Stromi1011/SelfBalancingRobot_Woita/README.md

# SelfBalancingRobot_Woita
Repository für unser Self-balancing-robot Projekt in PMT2

Die Sourcecodes, Artikel und Blender-Files sind in den jeweiligen Verzeichnissen zu finden.

Die für dieses Projet vervendete MPU6050 Bibliothek ist hier zu finden:
https://github.com/jarzebski/Arduino-MPU6050
