Stromi1011/SelfBalancingRobot_Woita/3D-Models/Gerust_self_balancing_Robot.stl

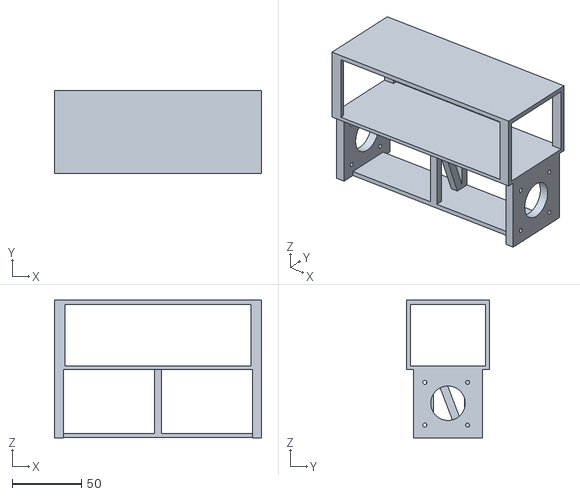
[picture p45: CAD file, 2021-06-26]
3D-Models/Gerust_self_balancing_Robot.stl
149.8 x 60.0 x 99.5
