Stromi1011/SelfBalancingRobot_Woita/(list of files, cad)

Other CAD files:
3D-Models/Gerust_self_balancing_Robot.blend
